kjnikhil6/EquBot/Design/1664011651291.jpg

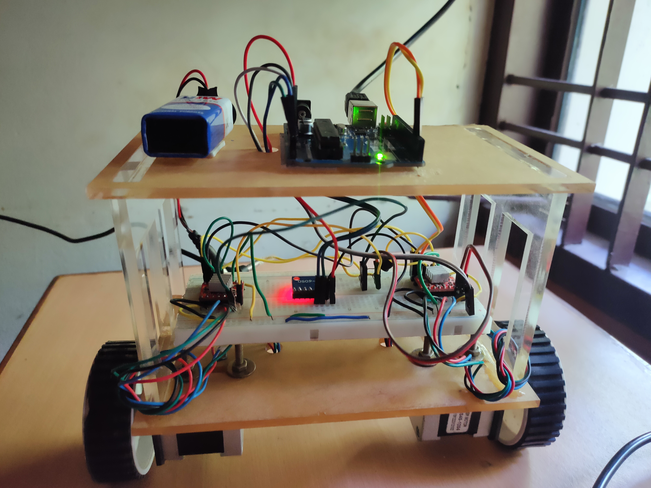
Design/1664011651291.jpg
